troyeta05/Centinela-IoT/Impresion 3D/Diagramas/Tinkercad Apoyos Retrasados.png

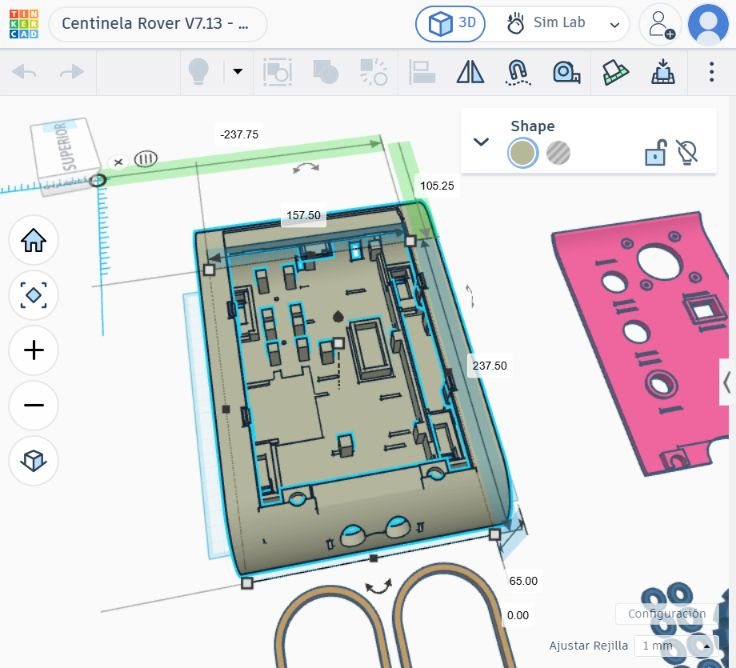
Impresion 3D/Diagramas/Tinkercad Apoyos Retrasados.png
