troyeta05/Centinela-IoT/Base de Datos/Diagrama ER.png

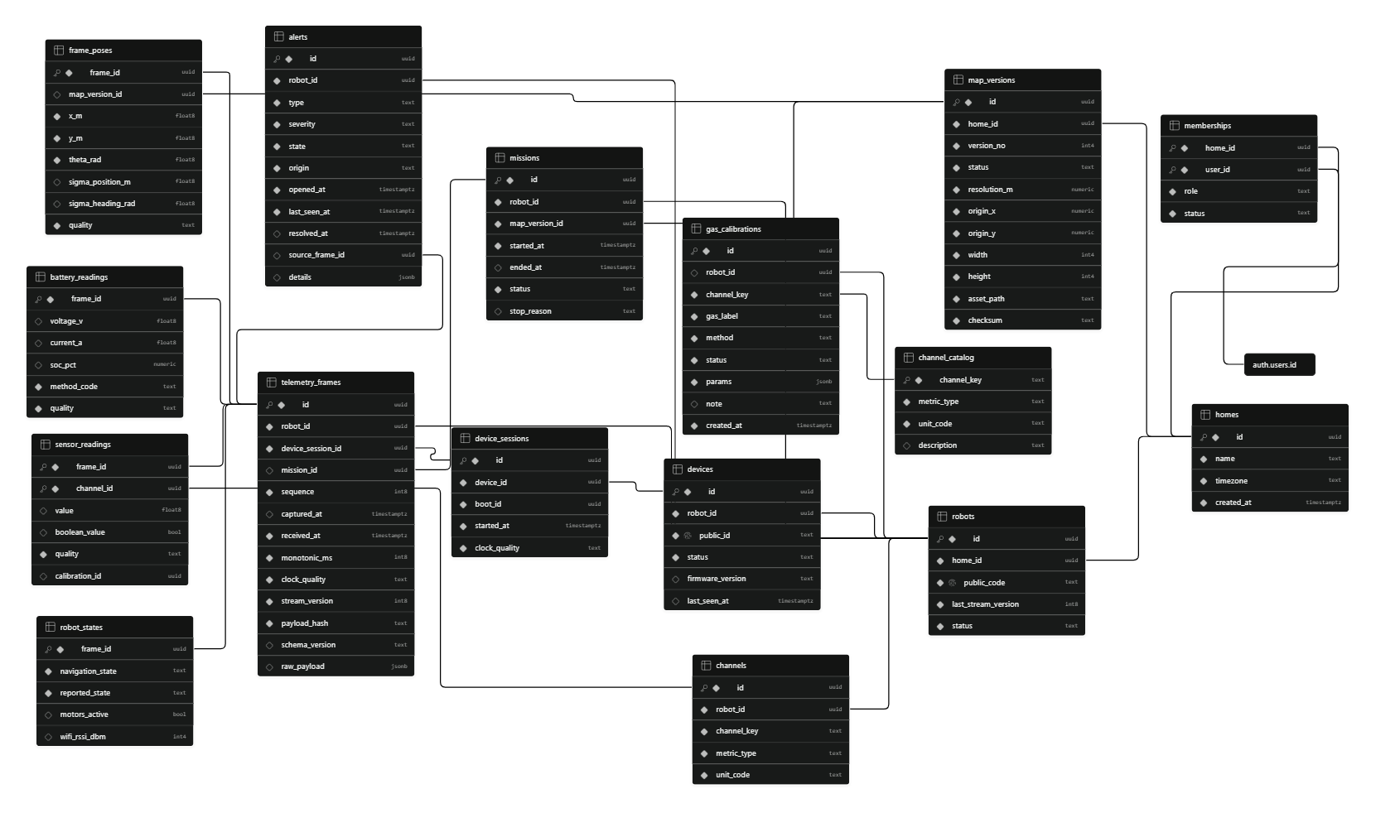
Base de Datos/Diagrama ER.png
