troyeta05/Centinela-IoT/Impresion 3D/Diagramas/Apoyos Retrasados.png

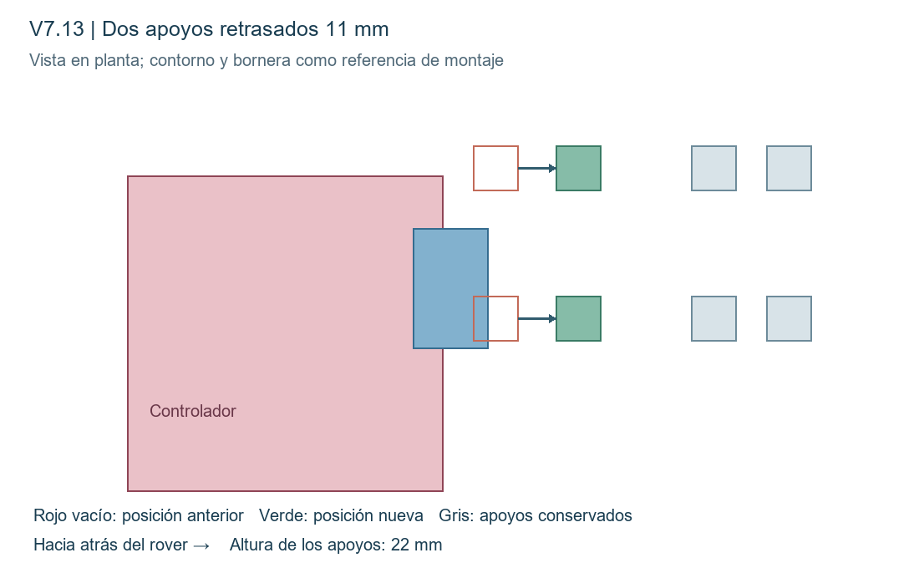
Impresion 3D/Diagramas/Apoyos Retrasados.png
