troyeta05/Centinela-IoT/Impresion 3D/Proyecto de Impresion 3D/Centinela Detector de Gases IoT.3mf

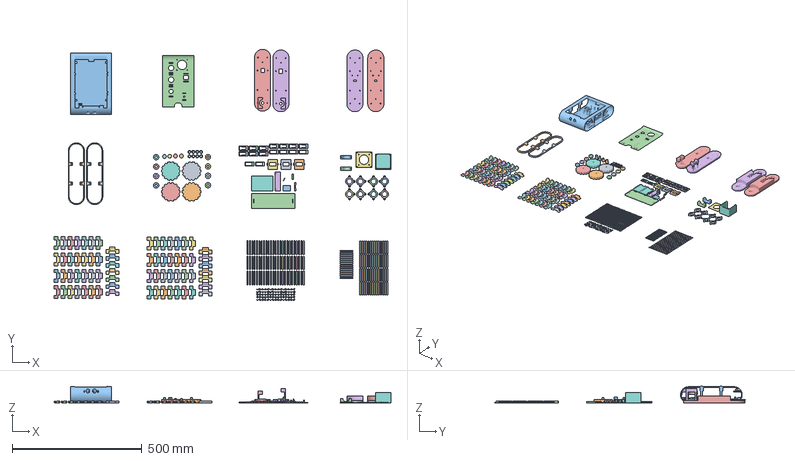
[picture p11: CAD file, 2026-11-03]
Impresion 3D/Proyecto de Impresion 3D/Centinela Detector de Gases IoT.3mf
1296.6 x 966.6 x 65.0 mm
Bisel x 2
Tapa de abrazadera x 2
Reten 608 trasero x 4
Reten 608 delantero x 4
Engranaje de oruga x 4
Separador exterior x 4
Muñon de rueda libre x 2
Separador interior x 4
Cuna del cargador
Bandeja protoboard
Apoyo ESP32
Cuna 18650
Portaplaca de gas x 3
Bandeja doble batería
Inserto de carga
Inserto programación
Eslabon de oruga x 70
Cuerpo centinela
Tapa centinela
Marco exterior x 2
Adaptador ventilador
Tapa ventilador
Calza IR x 16
Goma de contacto x 70
Pasador de oruga x 75
Reten de pasador x 75
Rondana buje muñon.stl x 8
Marco interno izquierdo.stl
Marco interno derecho.stl
Muñon de rueda hueco.stl x 2
