troyeta05/Centinela-IoT/Impresion 3D/STL por Bandeja/P02 Tapa.stl

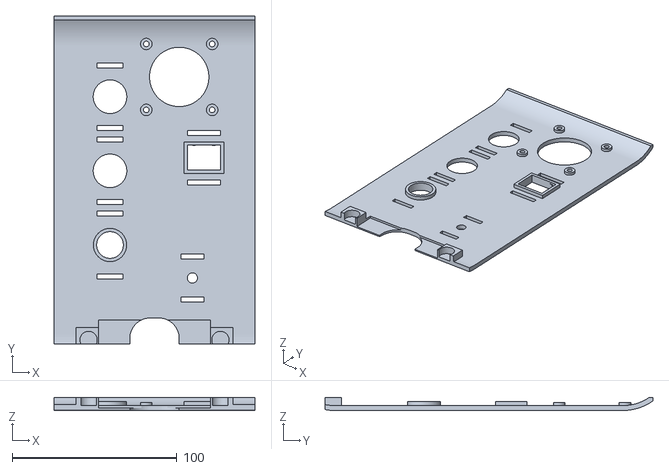
[picture p12: CAD file, 2026-11-03]
Impresion 3D/STL por Bandeja/P02 Tapa.stl
122.0 x 198.9 x 7.89
