troyeta05/Centinela-IoT/Impresion 3D/STL por Bandeja/P11 Pasadores.stl

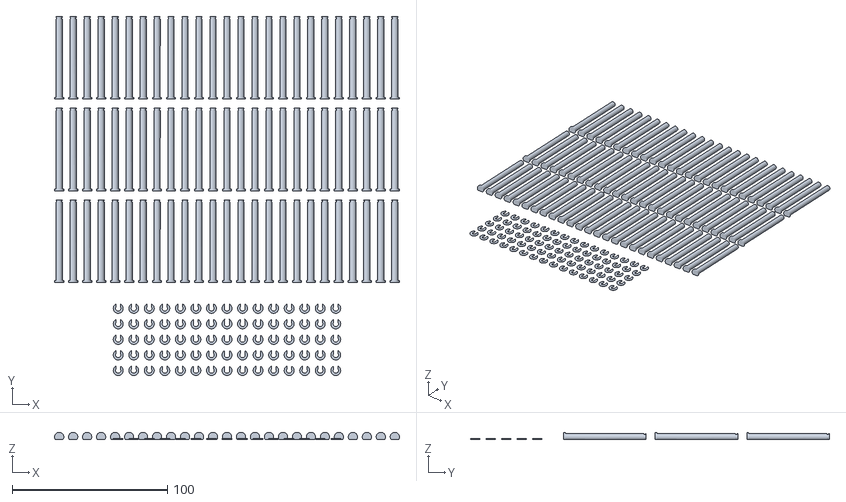
[picture p13: CAD file, 2026-11-03]
Impresion 3D/STL por Bandeja/P11 Pasadores.stl
222.0 x 231.0 x 4.80
