troyeta05/Centinela-IoT/Impresion 3D/STL por Bandeja/P03 Dos Marcos Interiores.stl

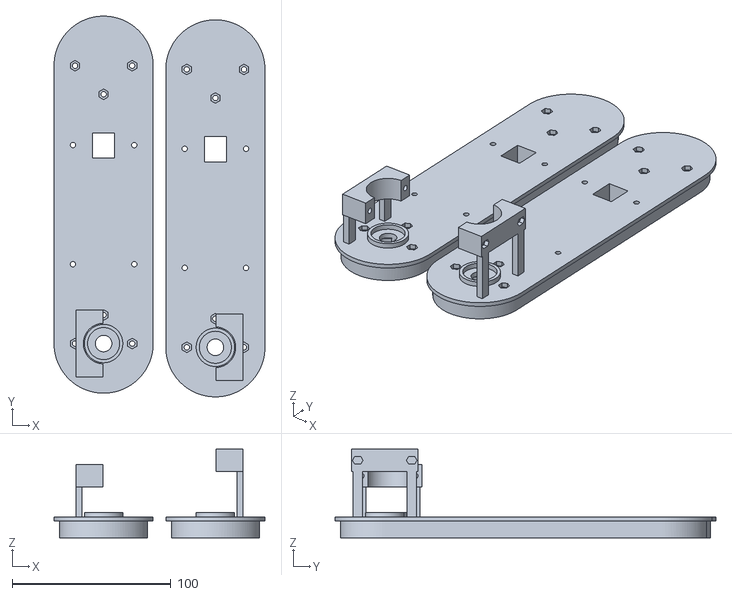
[picture p14: CAD file, 2026-11-03]
Impresion 3D/STL por Bandeja/P03 Dos Marcos Interiores.stl
132.9 x 239.8 x 55.8
