troyeta05/Centinela-IoT/Impresion 3D/STL por Bandeja/P05 Dos Biseles.stl

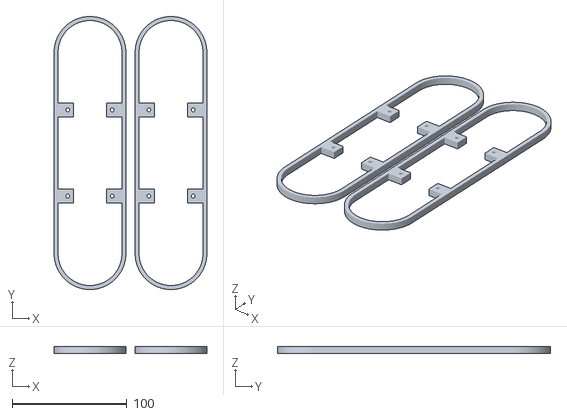
[picture p15: CAD file, 2026-11-03]
Impresion 3D/STL por Bandeja/P05 Dos Biseles.stl
133.0 x 237.5 x 6.00
