troyeta05/Centinela-IoT/Impresion 3D/STL por Bandeja/P01 Carcasa.stl

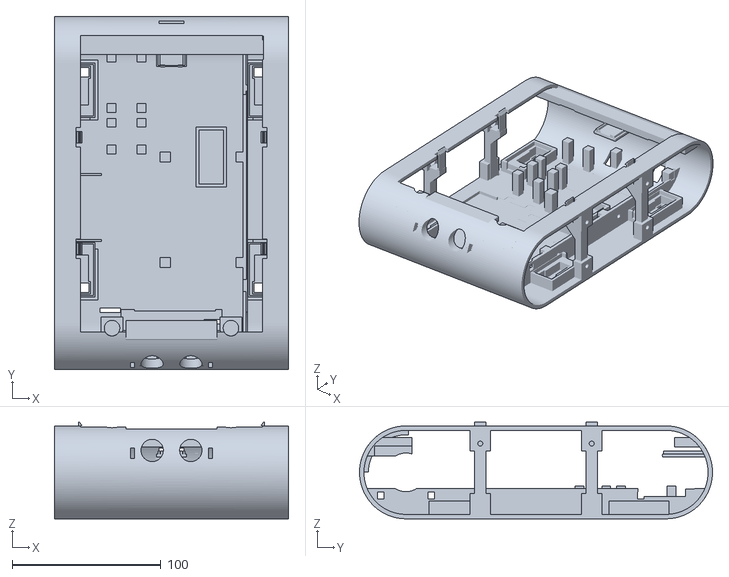
[picture p16: CAD file, 2026-11-03]
Impresion 3D/STL por Bandeja/P01 Carcasa.stl
157.5 x 237.5 x 65.0
