troyeta05/Centinela-IoT/Impresion 3D/STL por Bandeja/P07 Alojamientos y Bandejas.stl

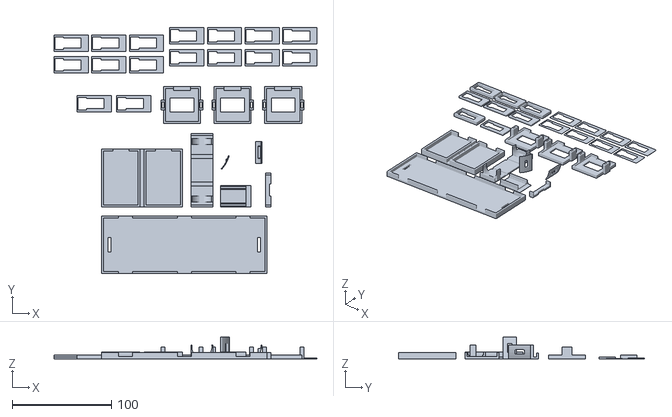
[picture p17: CAD file, 2026-11-03]
Impresion 3D/STL por Bandeja/P07 Alojamientos y Bandejas.stl
265.2 x 247.7 x 22.0
