troyeta05/Centinela-IoT/Impresion 3D/STL por Bandeja/P04 Dos Marcos Exteriores.stl

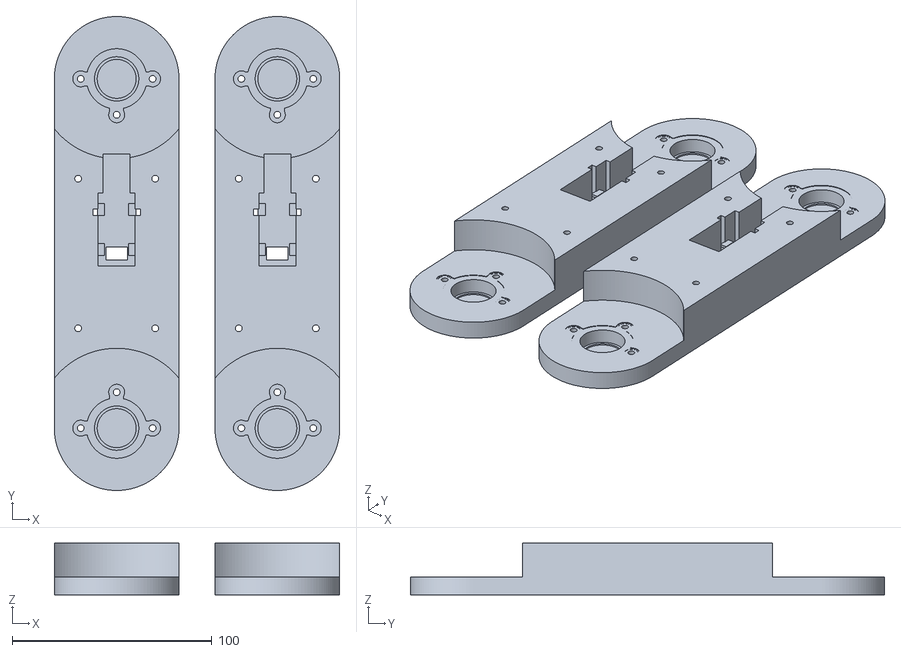
[picture p18: CAD file, 2026-11-03]
Impresion 3D/STL por Bandeja/P04 Dos Marcos Exteriores.stl
143.0 x 237.5 x 26.0
