troyeta05/Centinela-IoT/Impresion 3D/STL por Bandeja/P09 Eslabones.stl

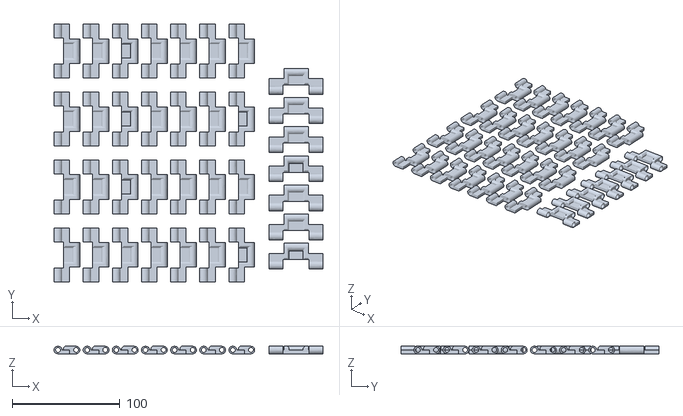
[picture p19: CAD file, 2026-11-03]
Impresion 3D/STL por Bandeja/P09 Eslabones.stl
249.3 x 239.0 x 7.03
