troyeta05/Centinela-IoT/Impresion 3D/STL por Bandeja/P06 Transmisión.stl

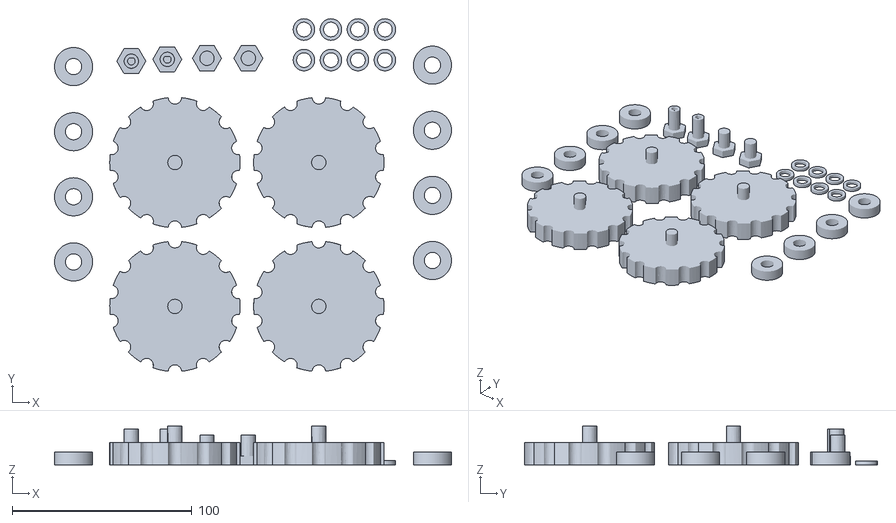
[picture p20: CAD file, 2026-11-03]
Impresion 3D/STL por Bandeja/P06 Transmisión.stl
220.7 x 196.0 x 21.5
