troyeta05/Centinela-IoT/Impresion 3D/STL por Bandeja/P08 Fijaciones.stl

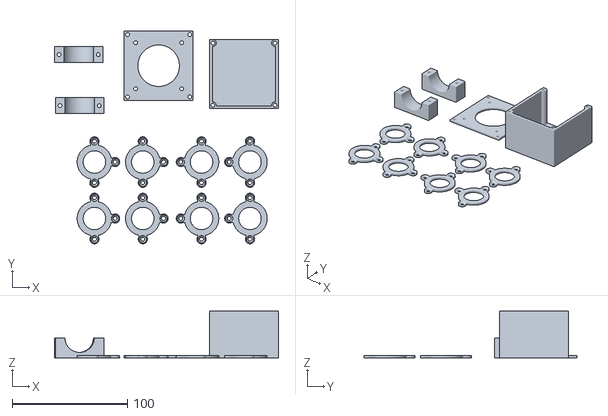
[picture p21: CAD file, 2026-11-03]
Impresion 3D/STL por Bandeja/P08 Fijaciones.stl
194.4 x 184.6 x 40.5
