troyeta05/Centinela-IoT/Impresion 3D/STL por Bandeja/P12 Gomas de Contacto.stl

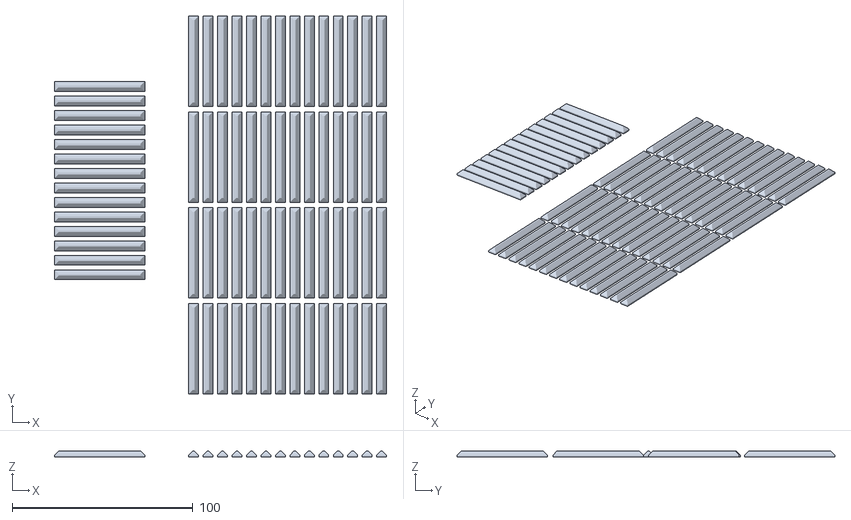
[picture p22: CAD file, 2026-11-03]
Impresion 3D/STL por Bandeja/P12 Gomas de Contacto.stl
183.7 x 209.0 x 3.26
