troyeta05/Centinela-IoT/(list of files, cad)

Other CAD files:
Impresion 3D/STL por Bandeja/P10 Eslabones.stl
