troyeta05/Centinela-IoT/Documentación/Centinela Pinout Completo.pdf

# Pinout completo del robot

### Todas las conexiones del montaje, componente por componente y desde la ESP32, con

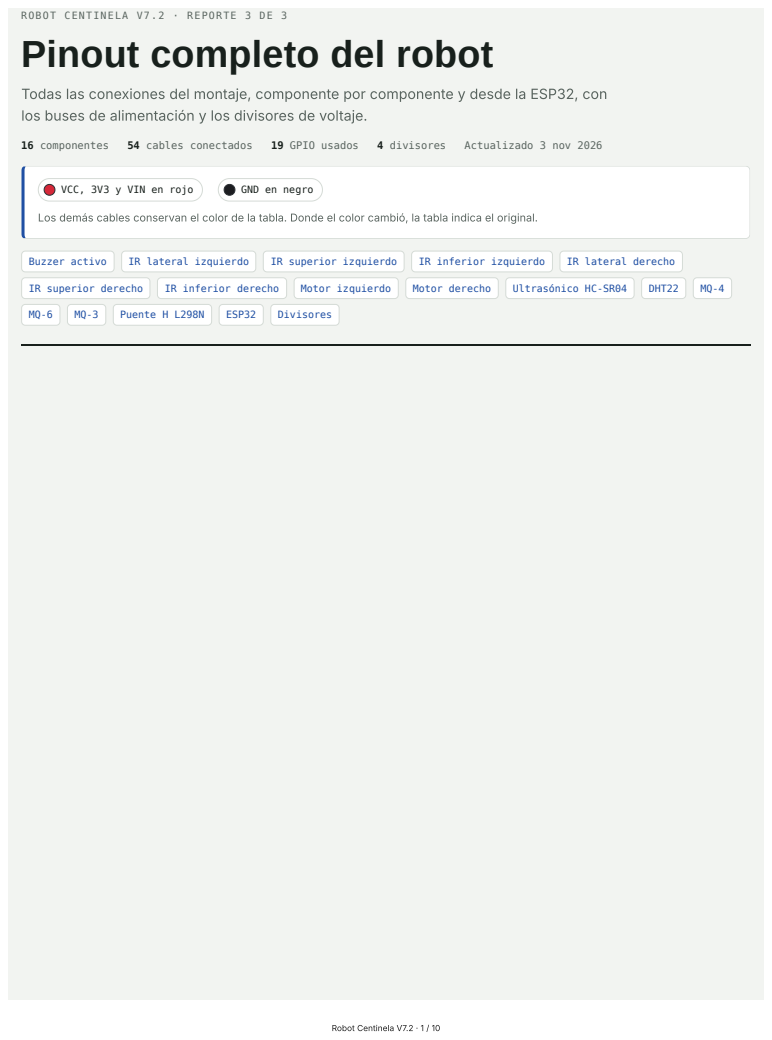
[picture p72: page 1]
16 componentes; 54 cables conectados; 19 GPIO usados; 4 divisores; Actualizado 3 nov 2026; VCC, 3V3 y VIN en rojo; GND en negro; Buzzer activo; IR lateral izquierdo; IR superior izquierdo; IR inferior izquierdo; IR lateral derecho; IR superior derecho; IR inferior derecho; Motor izquierdo; Motor derecho; Ultrasónico HC-SR04; DHT22; Puente H L298N; ESP32; Divisores; Robot Centinela V7.2 · 1 / 10

ROBOT CENTINELA V7.2 · REPORTE 3 DE 3

los buses de alimentación y los divisores de voltaje.

Los demás cables conservan el color de la tabla. Donde el color cambió, la tabla indica el original.

# Buses de alimentación

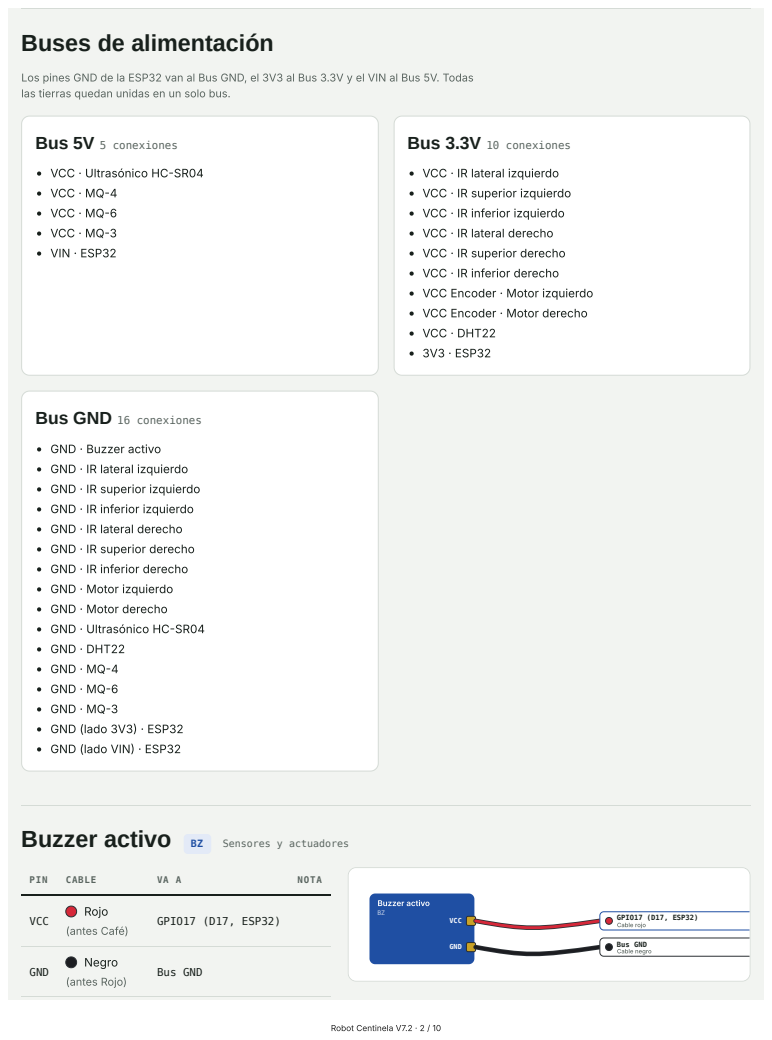
[picture p73: page 2]
Bus 5V 5 conexiones; Bus 3.3V 10 conexiones; Buzzer activo BZ; Sensores y actuadores; PIN; CABLE; NOTA; VCC; Rojo; (antes Café); GPIO17 (D17, ESP32); GND; Negro; (antes Rojo); Bus GND; Buzzer activo; Cable rojo; Cable negro

Los pines GND de la ESP32 van al Bus GND, el 3V3 al Bus 3.3V y el VIN al Bus 5V. Todas
las tierras quedan unidas en un solo bus.

VCC · Ultrasónico HC-SR04
VCC · MQ-4
VCC · MQ-6
VCC · MQ-3
VIN · ESP32

VCC · IR lateral izquierdo
VCC · IR superior izquierdo
VCC · IR inferior izquierdo
VCC · IR lateral derecho
VCC · IR superior derecho
VCC · IR inferior derecho
VCC Encoder · Motor izquierdo
VCC Encoder · Motor derecho
VCC · DHT22
3V3 · ESP32

Bus GND 16 conexiones

GND · Buzzer activo
GND · IR lateral izquierdo
GND · IR superior izquierdo
GND · IR inferior izquierdo
GND · IR lateral derecho
GND · IR superior derecho
GND · IR inferior derecho
GND · Motor izquierdo
GND · Motor derecho
GND · Ultrasónico HC-SR04
GND · DHT22
GND · MQ-4
GND · MQ-6
GND · MQ-3
GND (lado 3V3) · ESP32
GND (lado VIN) · ESP32

# Sensor infrarrojo TCRT5000 lateral izquierdo LI Infrarrojos

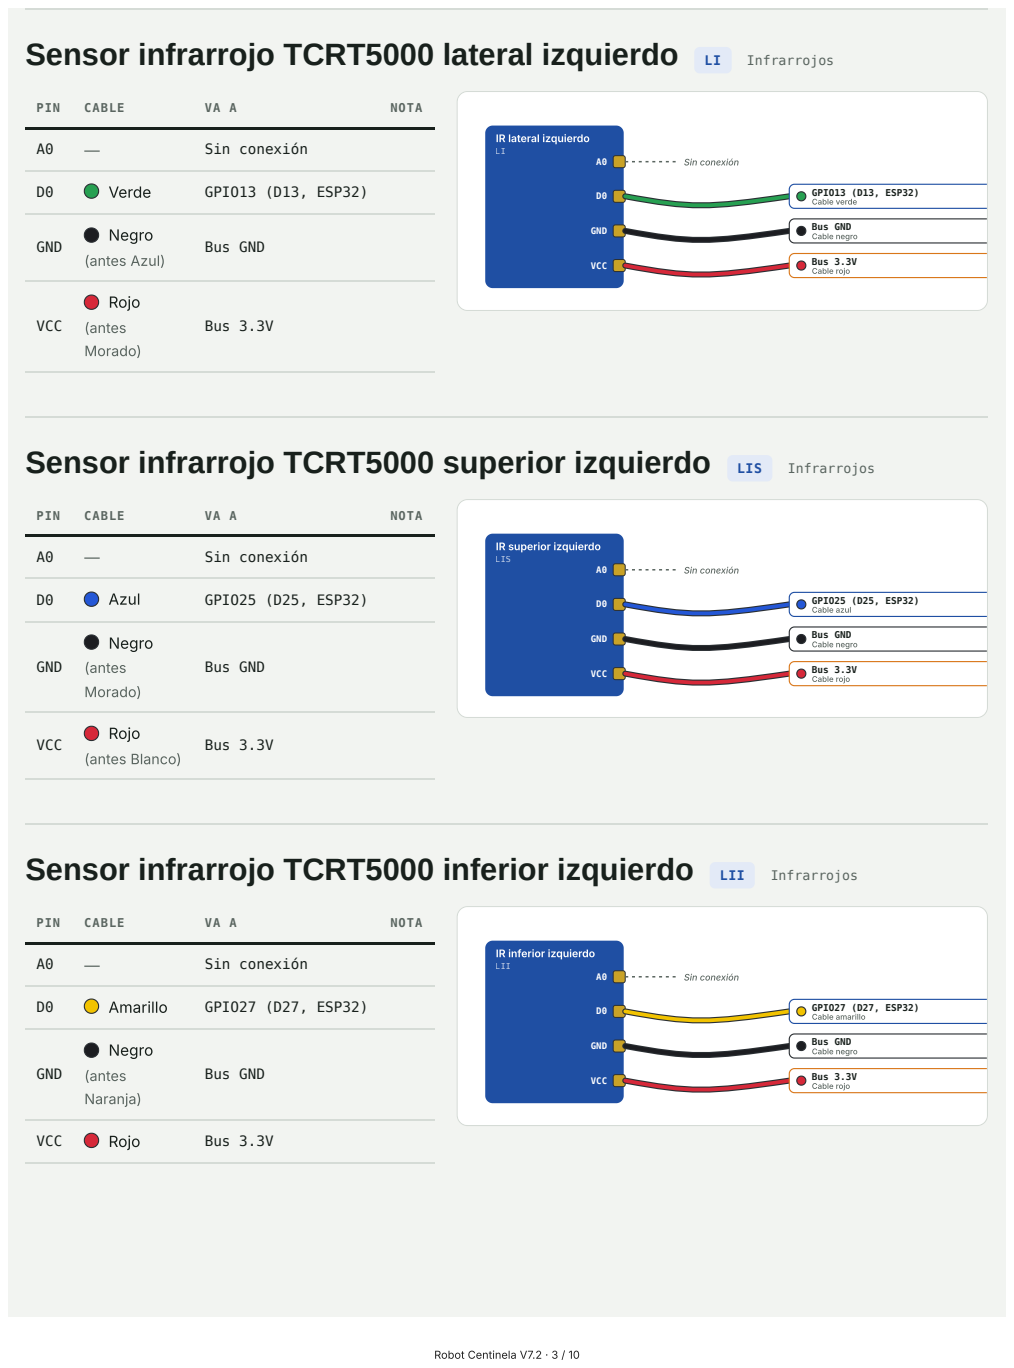
[picture p74: page 3]
PIN; CABLE; NOTA; Sin conexión; Verde; GPIO13 (D13, ESP32); GND; Negro; (antes Azul); Bus GND; VCC; Rojo; (antes Morado); Bus 3.3V; Cable verde; Cable negro; Cable rojo; Sensor infrarrojo TCRT5000 superior izquierdo LIS; Infrarrojos; Azul; GPIO25 (D25, ESP32); (antes; Morado); (antes Blanco); Cable azul; Sensor infrarrojo TCRT5000 inferior izquierdo LII; Amarillo; GPIO27 (D27, ESP32); (antes Naranja); Cable amarillo

IR lateral izquierdo

IR superior izquierdo
LIS

IR inferior izquierdo
LII

# Sensor infrarrojo TCRT5000 lateral derecho LD Infrarrojos

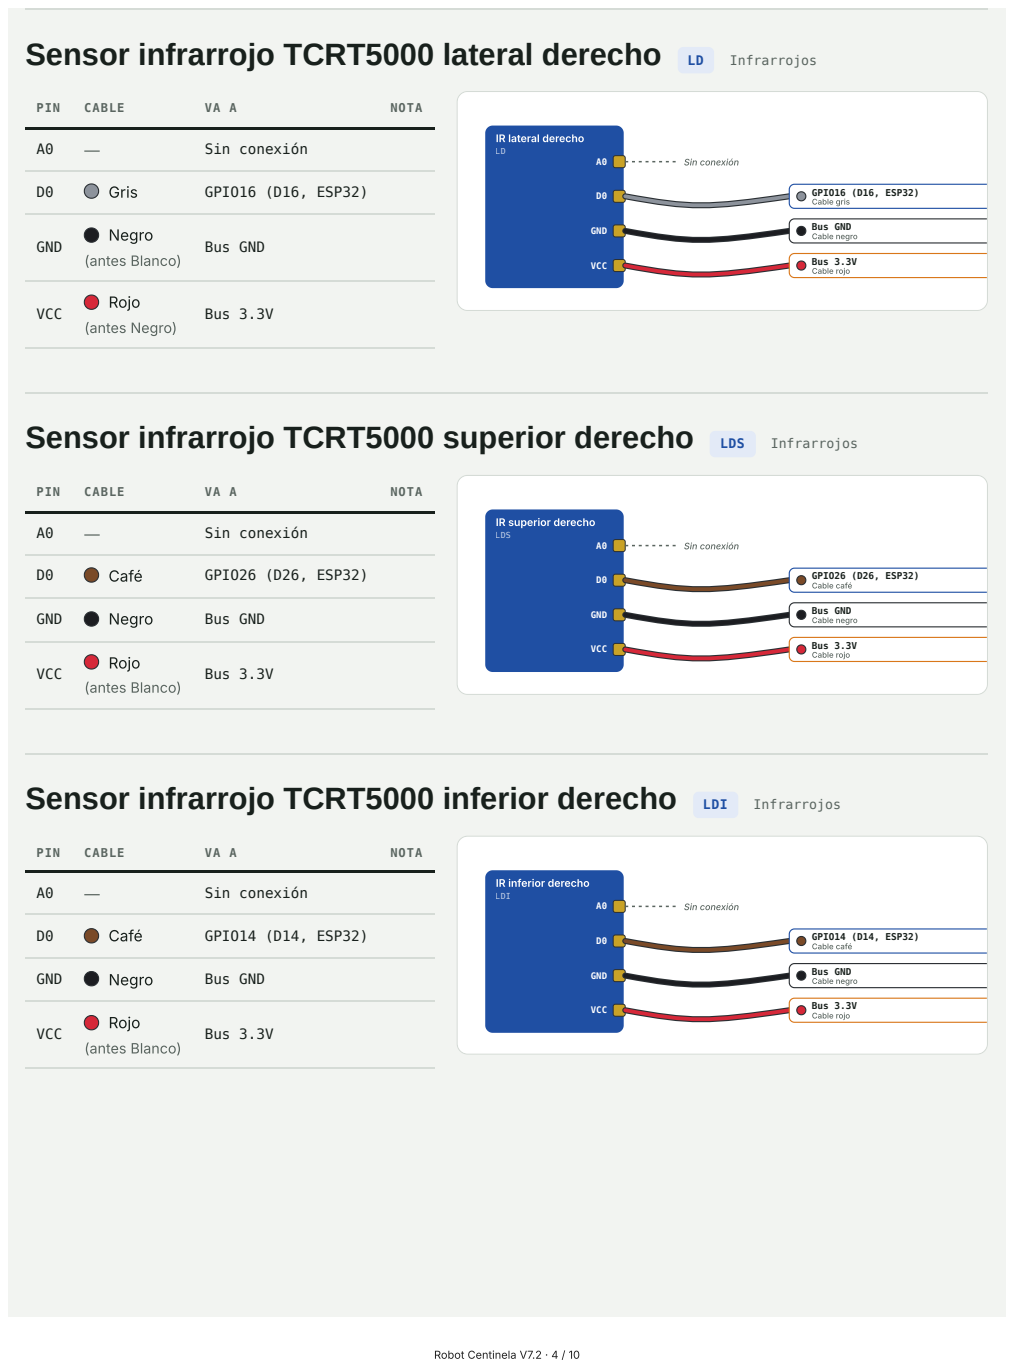
[picture p75: page 4]
PIN; CABLE; NOTA; Sin conexión; Gris; GPIO16 (D16, ESP32); GND; Negro; (antes Blanco); Bus GND; VCC; Rojo; (antes Negro); Bus 3.3V; Cable gris; Cable negro; Cable rojo; Sensor infrarrojo TCRT5000 superior derecho LDS; Infrarrojos; Café; GPIO26 (D26, ESP32); Cable café; Sensor infrarrojo TCRT5000 inferior derecho LDI; GPIO14 (D14, ESP32)

IR lateral derecho

IR superior derecho
LDS

IR inferior derecho
LDI

# Motor con encoder GM25-370 izquierdo MI Motores y puente H

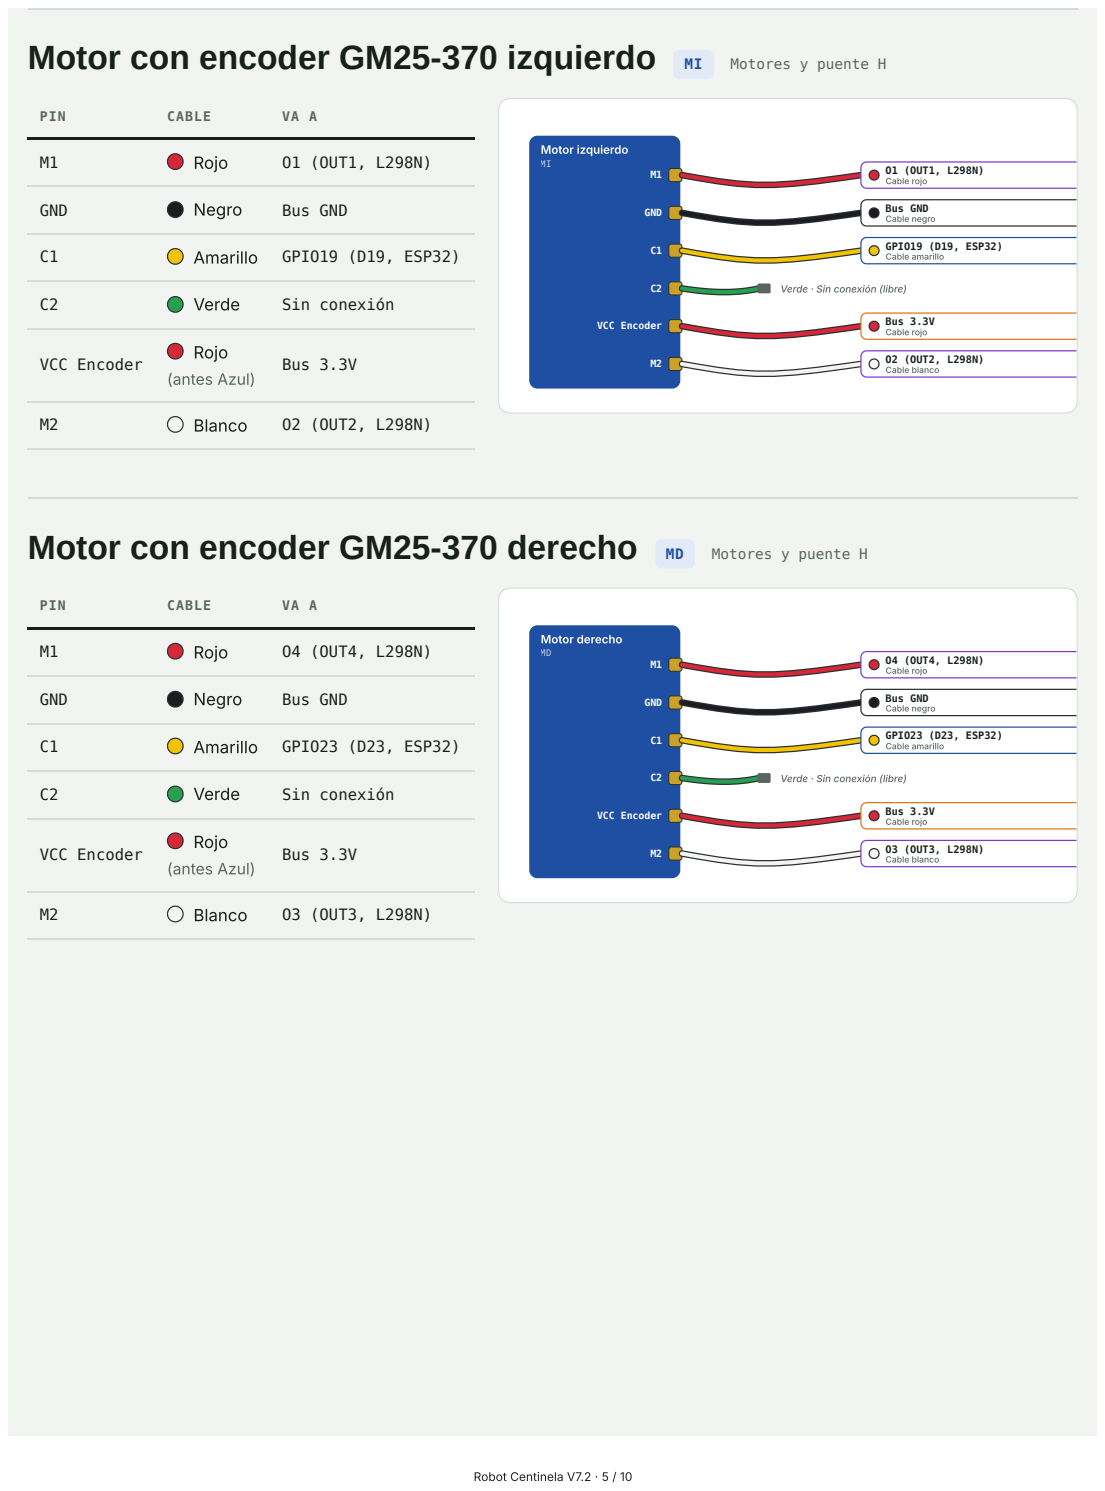
[picture p76: page 5]
PIN; CABLE; Rojo; O1 (OUT1, L298N); GND; Negro; Bus GND; Amarillo; GPIO19 (D19, ESP32); Verde; Sin conexión; VCC Encoder; (antes Azul); Bus 3.3V; Blanco; O2 (OUT2, L298N); Motor izquierdo; Cable rojo; Cable negro; Cable amarillo; Verde · Sin conexión (libre); Cable blanco; Motor con encoder GM25-370 derecho MD; Motores y puente H; O4 (OUT4, L298N); GPIO23 (D23, ESP32); O3 (OUT3, L298N); Motor derecho

# Sensor ultrasónico HC-SR04 SU Sensores y actuadores

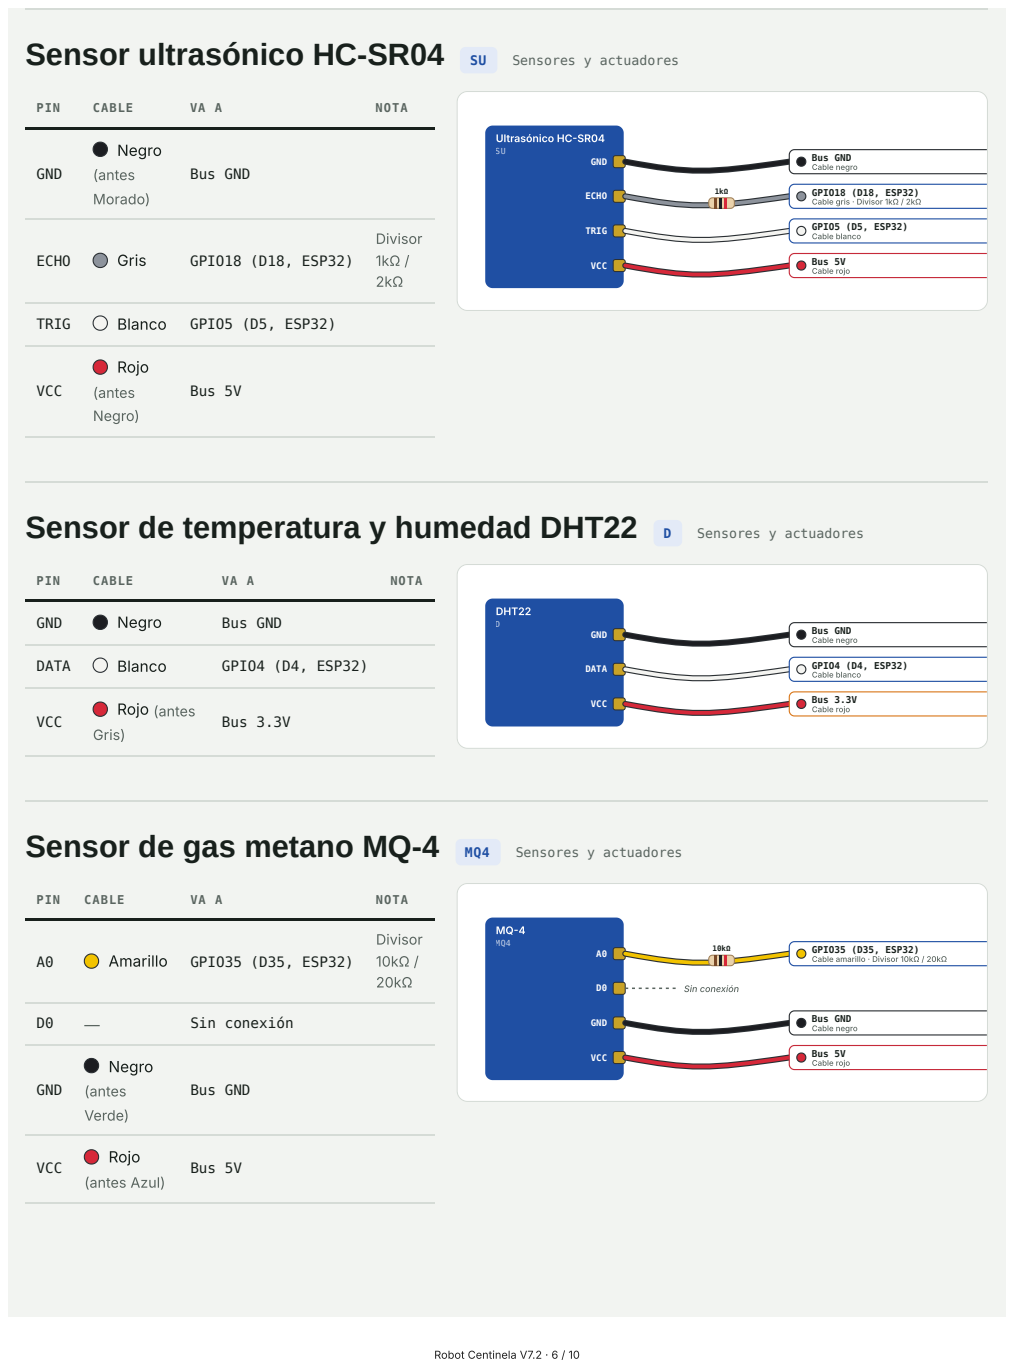
[picture p77: page 6]
PIN; CABLE; NOTA; GND; Negro; (antes; Morado); Bus GND; ECHO; Gris; GPIO18 (D18, ESP32); Divisor 1kΩ / 2kΩ; TRIG; Blanco; GPIO5 (D5, ESP32); VCC; Rojo; (antes Negro); Bus 5V; Ultrasónico HC-SR04; Cable negro; Cable blanco; Cable rojo; Sensor de temperatura y humedad DHT22 D; Sensores y actuadores; DATA; GPIO4 (D4, ESP32); Rojo (antes; Gris); Bus 3.3V; DHT22; Sensor de gas metano MQ-4 MQ4; Amarillo; GPIO35 (D35, ESP32); Divisor 10kΩ / 20kΩ; Sin conexión; Verde); (antes Azul)

Cable gris · Divisor 1kΩ / 2kΩ

Cable amarillo · Divisor 10kΩ / 20kΩ

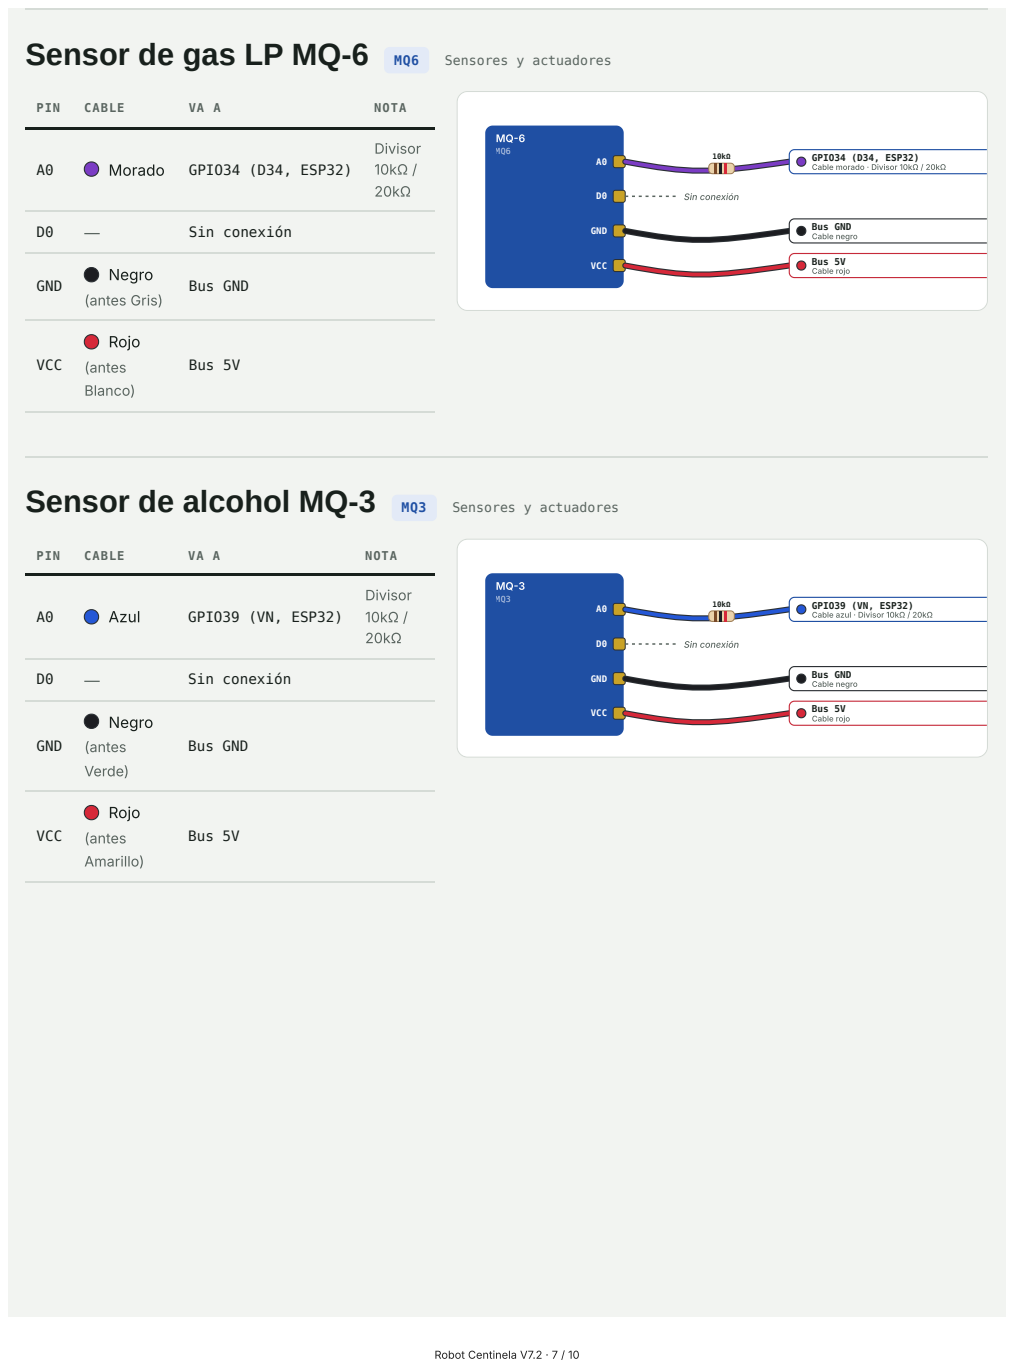
[picture p78: page 7]
Sensor de gas LP MQ-6 MQ6; Sensores y actuadores; PIN; CABLE; NOTA; Morado; GPIO34 (D34, ESP32); Divisor 10kΩ / 20kΩ; Sin conexión; GND; Negro; (antes Gris); Bus GND; VCC; Rojo; (antes Blanco); Bus 5V; Cable negro; Cable rojo; Sensor de alcohol MQ-3 MQ3; Azul; GPIO39 (VN, ESP32); (antes; Verde); (antes Amarillo)

Cable morado · Divisor 10kΩ / 20kΩ

Cable azul · Divisor 10kΩ / 20kΩ

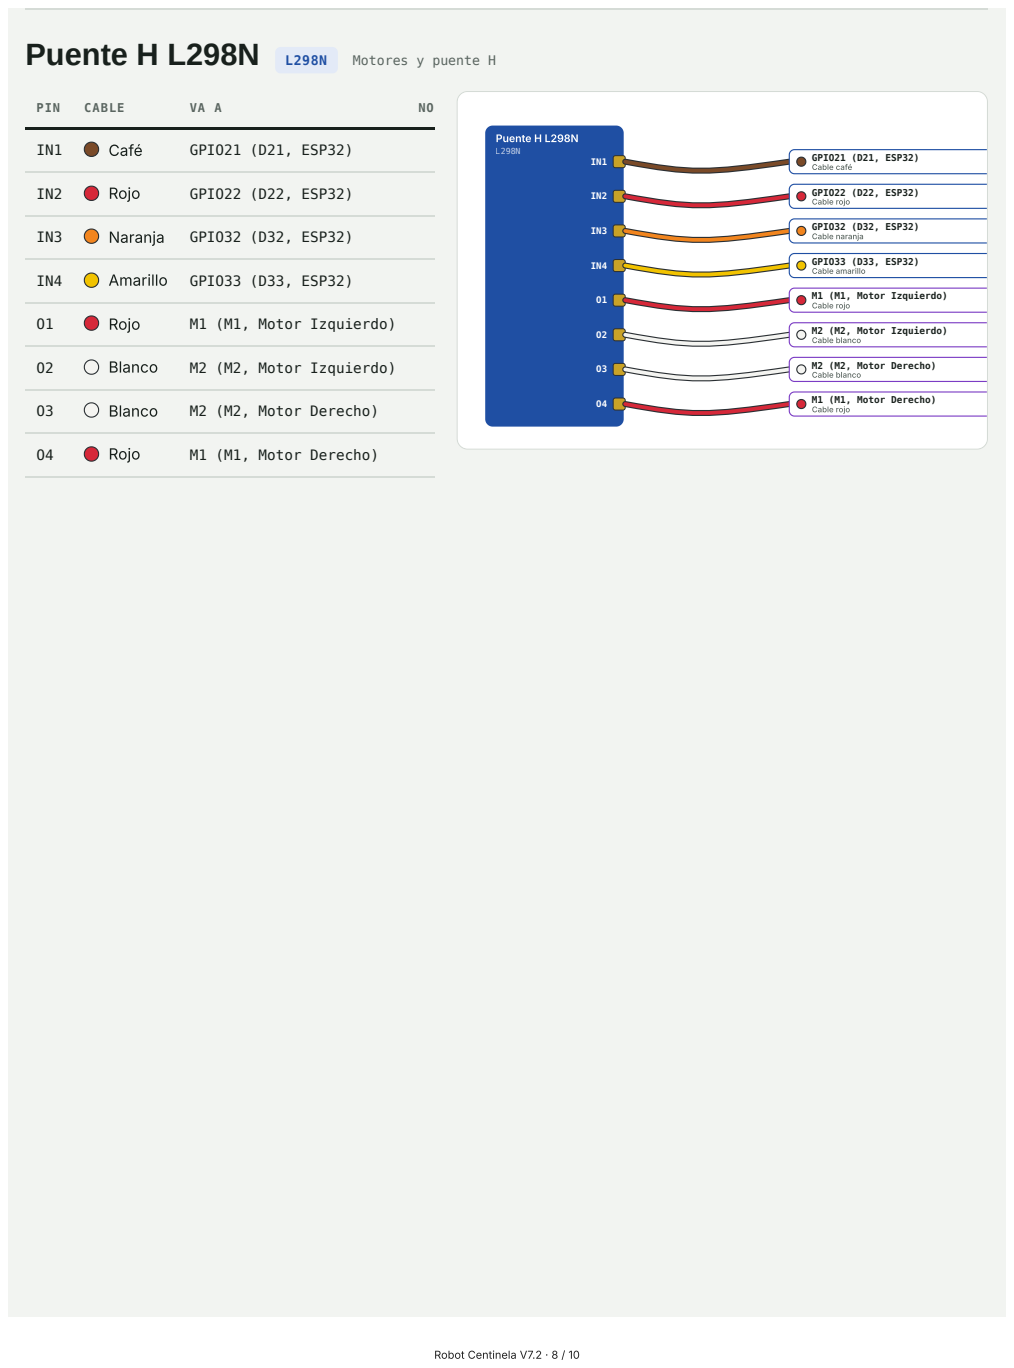
[picture p79: page 8]
Puente H L298N L298N; Motores y puente H; PIN; CABLE; Café; GPIO21 (D21, ESP32); Rojo; GPIO22 (D22, ESP32); Naranja; GPIO32 (D32, ESP32); Amarillo; GPIO33 (D33, ESP32); M1 (M1, Motor Izquierdo); Blanco; M2 (M2, Motor Izquierdo); M2 (M2, Motor Derecho); M1 (M1, Motor Derecho); Puente H L298N; Cable café; Cable rojo; Cable naranja; Cable amarillo; Cable blanco

# ESP32 DevKit (30 pines, USB-C) ESP32 19 GPIO + 3V3, VIN y 2 GND

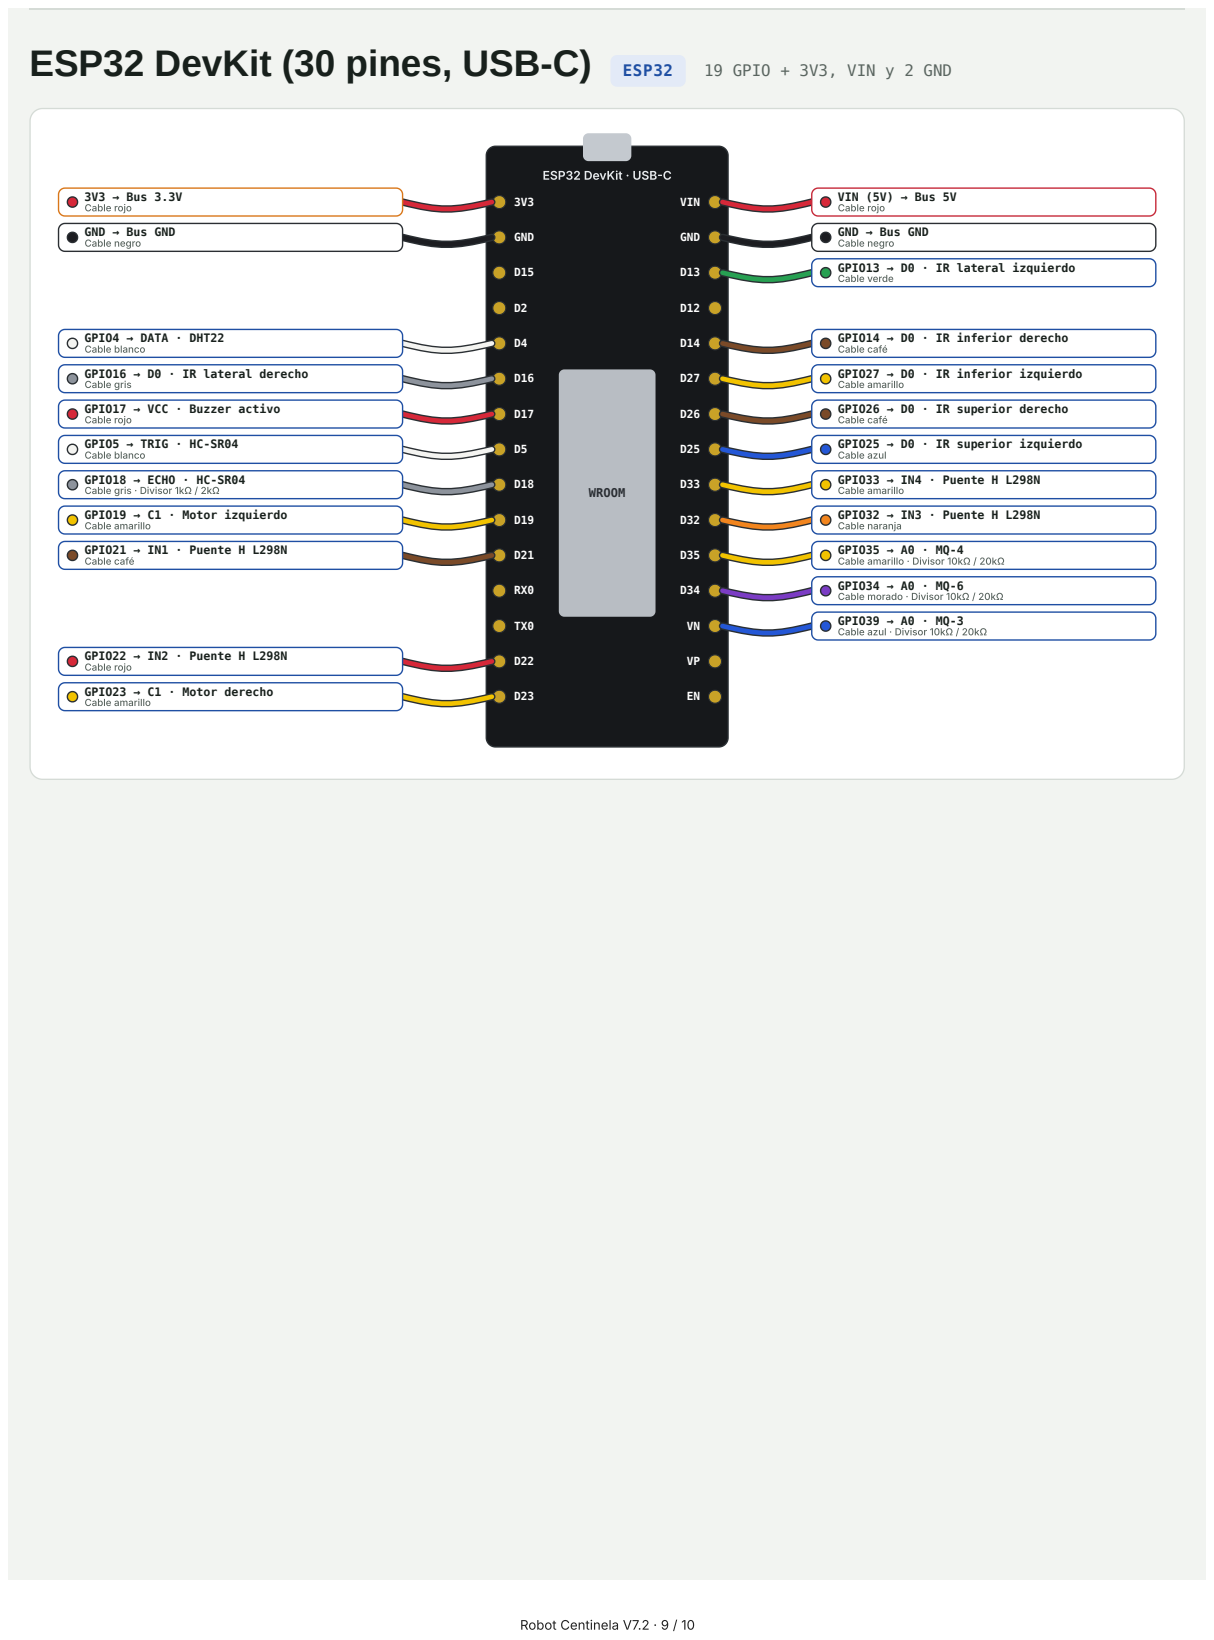
[picture p80: page 9]

3V3 3V3 → Bus 3.3V
Cable rojo
GND GND → Bus GND
Cable negro

## Lado de 3V3 (con el USB arriba)

## Lado de VIN (con el USB arriba)

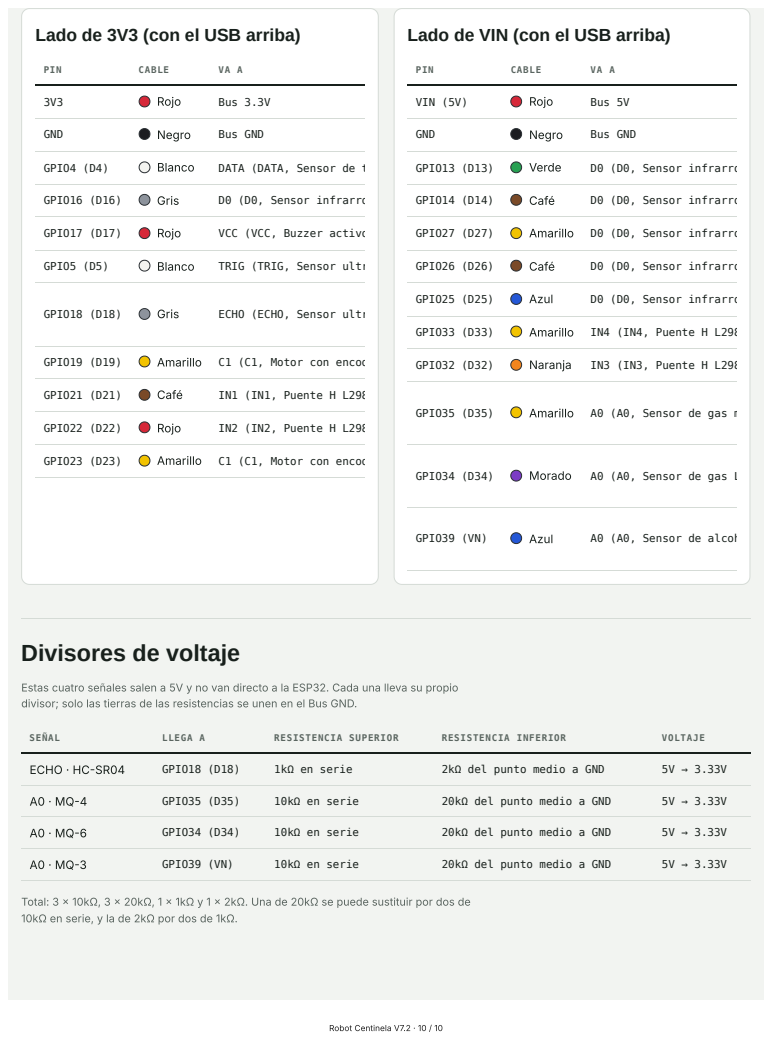
[picture p81: page 10]
PIN; CABLE; Rojo; Bus 3.3V; GND; Negro; Bus GND; GPIO4 (D4); Blanco; DATA (DATA, Sensor de t; GPIO16 (D16); Gris; D0 (D0, Sensor infrarro; GPIO17 (D17); VCC (VCC, Buzzer activo; GPIO5 (D5); TRIG (TRIG, Sensor ultr; GPIO18 (D18); ECHO (ECHO, Sensor ultr; GPIO19 (D19); Amarillo; C1 (C1, Motor con encod; GPIO21 (D21); Café; IN1 (IN1, Puente H L298; GPIO22 (D22); IN2 (IN2, Puente H L298; GPIO23 (D23); VIN (5V); Bus 5V; GPIO13 (D13); Verde; GPIO14 (D14); GPIO27 (D27); GPIO26 (D26); GPIO25 (D25)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

Divisores de voltaje

Estas cuatro señales salen a 5V y no van directo a la ESP32. Cada una lleva su propio
divisor; solo las tierras de las resistencias se unen en el Bus GND.

Total: 3 × 10kΩ, 3 × 20kΩ, 1 × 1kΩ y 1 × 2kΩ. Una de 20kΩ se puede sustituir por dos de
10kΩ en serie, y la de 2kΩ por dos de 1kΩ.
