troyeta05/Centinela-IoT/(commit log)

2026-10-22 Restructuración del Repositorio
    [Centinela Detector de Gases IoT.3mf, P01 Carcasa V7.stl, P02 Tapa.stl, P03 Dos Marcos Interiores.stl, P04 Dos Marcos Exteriores.stl, P05 Dos Biseles.stl, P06 Transmisión.stl, P07 Fijaciones.stl]
2026-10-22 Renombre de la BD
2026-10-26 Mejora del diseño de impresion 3D y de la base de datos
    [Centinela Detector de Gases IoT.3mf]
2026-10-28 Subida de Firmware
2026-11-03 Restructuración de modelo 3D
    [Centinela Detector de Gases IoT.3mf, P01 Carcasa V7.stl, P01 Carcasa.stl, P02 Tapa.stl, P03 Dos Marcos Interiores.stl, P04 Dos Marcos Exteriores.stl, P05 Dos Biseles.stl, P06 Transmisión.stl]
2026-11-03 Pruebas Unitarias de Componentes
2026-11-03 Actualización de Documentación
